newro0209/scara-dev/parts/carriage_link.scad

include <column_link.scad>

// TODO: SCARA_KINEMATICS.md를 보고 CARRIAGE_LINK를 column_link.scad 처럼 스케폴딩 한다. (주의! 스케폴딩만 하고, 실제 제작 부품은 만들지 않는다.)
